michal-kuca/Water-rocket-telemetry/water_rocket_telemetry/Rocket_project_report.docx

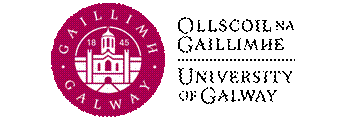
[picture p1: figure]

School of Engineering

Report/Assignment Cover Page

Student/Group Name(s): | Student(s) ID Number:
Michal Kuca Danny Cannon Shifrah Burke Beirne Nicola Latham | 25459142 25377696 25457496 25741946

Class and Year (e.g., 1st Undenominated Engineering): | 1st Undenominated Engineering
Subject Code and Name: (e.g. EI140 Fundamentals of Engineering) | 1EG1
Lecturer Name: | Liam Kilmartin Rajkumar Sarma
Title of Report/Assignment: | NUIG Lander Report
Submission Deadline: | 05/04/2026
Submission Date: | 05/04/2026
Name(s) of Lab Partner(s) (where applicable) | Danny Cannon Shifrah Burke Beirne Nicola Latham Michal Kuca

# 1. Introduction and Aims of the Project

The project aimed to design, build, and safely test a water rocket system that must be capable of launching a capsule and parachute. The system was required to carry a payload consisting of an Arduino system and ensure the capsule could safely descend within specific criteria.

To achieve this, the project was divided into several key stages:

- Design and construct a water pressure-based launcher capable of propelling the rocket to a sufficient height to allow parachute deployment.
- Design and construct a rocket with the ability to hold a capsule built within specified constraints to hold an Arduino system.
- Maximum capsule diameter: 7.5 cm.
- Maximum capsule length: 20 cm.
- Maximum capsule mass: 250g.
- Design, manufacture, and test the parachute system to ensure the capsule returns safely to ground within the required descent speed limits.
- Development and testing of an Arduino program to collect and transmit real-time sensor data, including forces, velocity, altitude and distance during pre-launch, ascent and descent phases.
- Assembly of all components (rocket, capsule, parachute and Arduino system) and testing the launching mechanism while recording flight data.
- Analysis of the collected data to evaluate the rockets performance and dynamics.
- Presentation and reporting of the results and findings.

# 2. Rocket

2.1 The rocket works using a water propulsion system where compressed air forces water out of the bottle to produce thrust. This follows Newton’s Third Law, which states that for every action, there is an equal and opposite reaction. As water is pushed out at high speed, the rocket is pushed upwards.

The thrust produced depends on how fast the water leaves the rocket and how much water is being expelled. For us, we filled our bottle roughly 1/3 of the way. It can be estimated using:

F = mv

Where is F is thrust(force), m is mass (kg/s) and v is velocity of water leaving (m/s).

The velocity of the water depends on the pressure inside the rocket and can be estimated by:

V = √(2P/)

Where P is pressure(Pa) and is density of water(1000 kg/m³).

For the rocket to lift off, the thrust must be greater than its weight:

W=mg

2.2 The rocket is a vital design component of the project because it is used to launch and keep the capsule containing the Arduino system safe. Designs were discussed between the group to decide which would work best for our capsule, parachute and in general on the final testing day.

1. Structure
- Used a plastic bottle as the pressure vessel due to its strength and lightweight properties.
- Filled the bottle partially (about 1/3 full) with water to optimise thrust and flight time.
2. Capsule housing
- Designed a secure nose cone for the top section to hold the capsule and parachute explained in the following sections.
- Protected the capsule inside, including the Arduino which was protected by a sponge, and released safely at a peak height, which for us was 6.16m.
3. Stability
- Chose that our design would include three fins attached at the base of our rocket to ensure it could be free-standing as well as ensuring flight stability.
- Fins ensure the rocket can stand upright before launch and create a stable, straight flight by keeping the centre of pressure below the centre of mass.
4. Propulsion
- Used a water and compressed air system.
- Implemented a football needle valve system using a bicycle pump as required.
- Launch occurs when pressure from the pump through the valve that has been poked through the cork forces the cork-valve system to release, ie. No manual release used.
5. Launch compatibility
- Designed the rocket to fit the provided launch platform and pump system for day of final testing.
- Sealed nozzle tightly to prevent air leaks.
6. Safety considerations
- Used strong materials to withstand pressure, ie. plastic.
- Secure attachments for fins and nose cone.
- Arduino system kept dry inside the capsule using a washer sponge.
- Ensured design creates safe release and controlled descent using a parachute and testing it.
7. Additional
- Streamlined nose cone reduces air resistance.
- Lightweight materials maximise height during launching.
- Balanced mass distribution improves stability.

# 3. Capsule and Parachute System

## 3.1 Capsule

To begin the project the bottles were bought so that the preparation for testing could begin. After watching some previous testing videos, it was decided that a demonstration capsule would be built and the decision on what type of bottle to use for the final capsule would be made upon the results of the test. The bottles that were chosen for the tests were round bottles as when the square bottles were used, they did not seem to sit together as good. For the drop test two small 750ml bottles were used, they were cut up so that they would sit together and there would be a section for the Arduino, for the water and section for the parachute to sit. There was also double layered cardboard used as fins for the stand.

For this test the capsule performed well but it was quickly understood that for the final test a bigger bottle would be needed as the pressure needed to be created in the capsule as the bigger the capsule the more pressure that can be obtained. For the final test 2 large 2 Litre bottles were purchased and similarly they were cut up so the 3 sections could be made.

Three sections needed to be created for the final test, one for the water/ air mixture, one empty section that would hold the parachute and the third and final section that would hold the Arduino. To begin the fins were sketched on cardboard then cut up, double layered and wrapped in duct tape to ensure they were sturdy and wouldn't get weak if water was to get on them. After this the fins were superglued to bottle A, small pieces of duct tape was added to the side of the bottle and the fins to ensure they were stable.

Following this bottle B was cut as only the middle section was needed as this was the section that the top of the capsule was going to be sitting into and where the parachute would be held. The top and bottom of bottle B were then taped together to create a small capsule to hold the Arduino, this worked well as when the mini capsule was placed on top of the big capsule it sat perfectly together.

The mini capsule had to be constructed within the limitations of a 75mm width, 200mm height and a max weight of 250g. In the mini capsule sponges were added to ensure no damage would come to the Arduino if the parachute did not deploy and the mini capsule fell to the ground also there was a hole cut near the top of the bottle so that when the Arduino was placed into the bottle and secured the battery could be accessed.

The plan for the capsule was that when there was enough pressure in the main capsule, the cork would come out and the capsule would fly into the air and then the parachute would deploy, and the mini capsule would then glide downwards whilst the readings being taken on the Arduino.

## 3.2 Parachute

In this project, we had the responsibility of designing a parachute that would slow the capsule's descent by enhancing air resistance. The system is described by the following formula from fluid dynamics to calculate the upwards force created by the parachute:

We calculated the weight of our capsule using this formula:

By making these formulas equal, we could figure out the parachute's radius by rearranging the formula to get the following:

We created a program in MATLAB to show the range of values for the radius based off the mass of the capsule and the velocity of descension desired.

v = input('Velocity: ');

m = input('Mass: ');

fd = m*9.81;

Rho = 1.22;

Drag = linspace(1,1.75,100);

r = sqrt((2*fd) ./ (Rho .* Drag .* pi .* v.^2));

r_max = max(r);

disp(r_max);

plot(Drag,r,"r", 'LineWidth', 2);

xlabel("Drag");

ylabel("Radius");

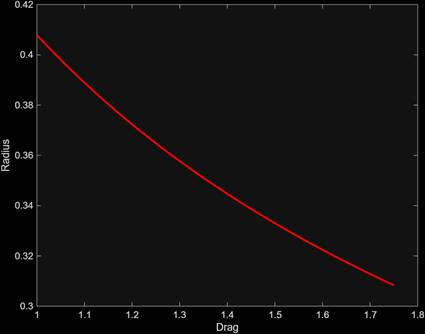
[picture p2: figure]

In the example above, the mass was 130 g, and the falling velocity was two metres. The program states in the least optimal scenario the parachute's radius would be 40.79 cm.

The design process was based on the results of the program.

For the physical construction of the parachute, a black bin bag was cut into a circle with the radius from the program. Then a small incision was made in the centre with a radius of about 2 cm. This step is to control airflow and keep the parachute stable during its descent.

A final design feature of our parachute was its slight domical shape. By removing a 20° sector from the circle, the parachute fills with air to create a dome shape, leading to more air being caught.

With the parachute cut, eight lengths of string 1.5x the length of the radius were attached to create the shroud lines. The strings were then collected at the bottom as a pivot for the capsule.

Finally, a hook was added to the apex of the dome where it could be placed on the side of the rocket.

# 4. Arduino System

## 4.1 Arduino System Overview

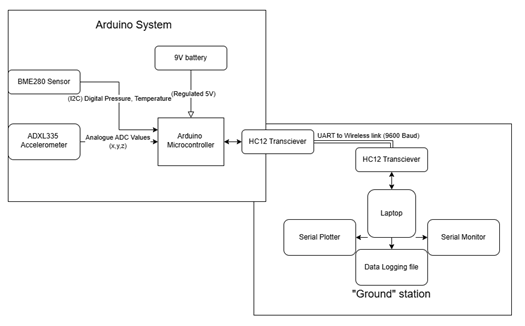
[picture p3: figure]

Figure 1: Arduino System overview

Figure 1 presents an overview of the system used to gather data in this project. The Arduino chip, which functions as the computation centre, is powered by a 9 V battery but receives only regulated 5 V. It receives values from sensors on board the rocket, including the BME280 pressure and temperature sensor and the ADXL accelerometer. This data is then sent via a 433 MHz radio wave to the laptop on the ground, which enables monitoring, plotting, and logging of the data received.

## 4.2 Arduino System components

4.2.1 ADXL335 Accelerometer

The ADXL335 accelerometer transmits analogue signals to the Arduino Nano for accelerations in X, Y and Z directions. The sensor (As simplified by figure 2) functions on the principle of a proof of mass (one in each direction), which moves between fixed plates, changing capacitance.

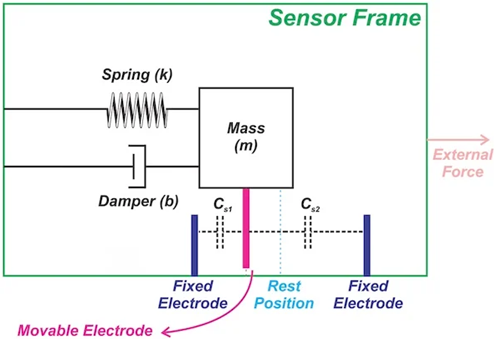
[picture p4: figure]

Figure 2: MEMS accelerometer (DigiKey, n.d.)

Capacitance is defined as:

Figure 3: Capacitance Formula

Where and are constants, and is the area of overlap between the plates, and d is the separation between plates. Therefore, with constant plate area, capacitance is inversely proportional to the separation distance.

As the sensor casing accelerates (due to an external force), the mass m, suspended on elastic bands, lags behind due to inertia (Last Minute Engineers, n.d.). This changes the size of the separation , and the capacitance. This value is converted to a voltage signal within the accelerometer’s internal circuits, and is sent to the Arduino board. The Arduino board then uses an ADC (analogue to digital converter), which converts signals to values between 0-1023.

### 4.2.2 BMP280 Sensor

The BMP280 detects changes to barometric pressure using a piezoresistive pressure sensor – a sensor which varies electrical resistance due to pressure or compression. The internal, ‘silicon diaphragm’ (Bosch Sensortec, 2015), bends based on atmospheric pressure. Similarly, the chip measures temperature using a bandgap sensor (Bosch Sensortec, 2015). Unlike the accelerometer, this sensor includes an ADC, and sends digital, temperature and pressure values to the Arduino board. Altitude is then calculated separately, based on these two readings, using ground pressure as a reference point.

### 4.2.3 HC12 Radio Link

The system utilises a radio communication system, using two HC12 Transceiver modules, connecting the Arduino to the ground station. (Figure 1). The Arduino sends the processed sensor data (as a csv formatted string) to the HC12 module. The baud rate was set to the default setting of 9600 baud, (9600 bits of info transferred per second).

The necessary baud rate can be estimated by calculating the amount of info sent from the Arduino. Given that there were 7 float values sent, as well as the ‘,’ delimiters, and a ‘newline’ operator. There are circa 60 characters per line. As each character in UART is around 10bits (Salisbury, 2017), the total transferred in one sample is

As the controlled sampling rate was 100ms, we can calculate the baud rate by:

Figure 4: Baud rate formula (Sarma, 2026)

= 6000 Baud

This would mean that the amount of data transferred is 62.5% of its maximum rate. As lower baud rates increase reliability, but decrease transmission speed and can risk buffer overflow. Therefore, this rate was deemed sufficient to balance these two factors.

Upon transmission the ‘rocket’ HC-12 module converts the serial data into a 433 MHz radio frequency (Hughes, 2016). The ‘ground’ HC-12 then reads the signal, and the signal is ‘demodulated’ back into the original (Serial) format (Hughes, 2016). This data is then received by the computer/laptop and displayed using Serial Plotter.

## 4.3 Arduino Program

## 4.3.1 Core Structure

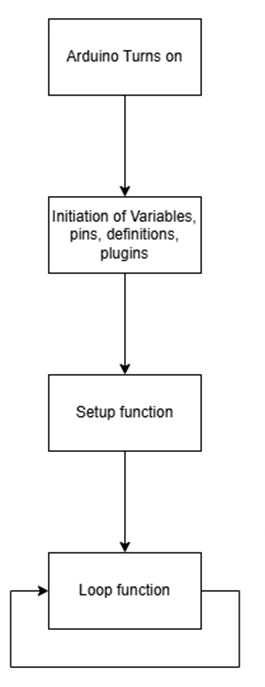
[picture p5: figure]

Figure 5: Arduino core implementation

After powering on, the programme uploaded to the Arduino compiler initialises global variables and defines pins and libraries which are included. Commands which are only to be run one time are executed using the setup function. For the purposes of this program, for example, temperature and ground pressure readings are swept:

for(int i=0;i<10;i++){

float P=climate_sensor.readPressure()/100

float T=climate_sensor.readTemperature()

sumP=sumP+P;

sumT=sumT+T;

delay(50); //the pressure readings will be done in 0.5s

}

ground_pressure= sumP/10; //takes the average

launch_temp= sumT/10;

}

Figure 6: Initial Temperature and Pressure readings

The setup function also defines sensor inputs and initialises Serial, I2C and the HC12 connection.

Loop function contains the active element of the code, which updates indefinitely after startup is finished, its basic components outlined by Figure 14.

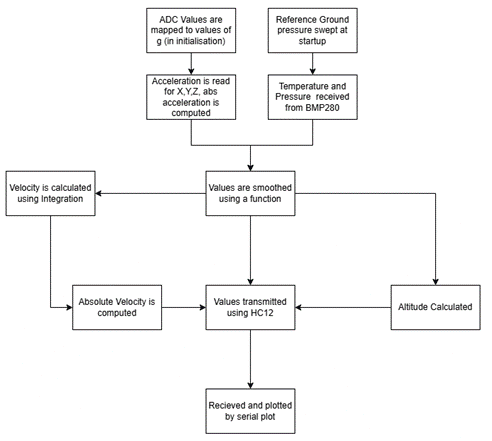
[picture p6: figure]

Figure 7: Drop test Data Flow Arduino

### 4.3.2 Data Processing

Acceleration calculation

Initially, Minimum and Maximum values for 1g are declared, after calibration. After determining the Range as the difference between these values , and ( as the Centrepoint (Sarma, R. 2026).

float readAcceleration(float rawValue, float offset, float scale){

float accel = 0.0;

accel = (rawValue - offset)*(9.81 / scale);

return accel;

}

Figure 8: Read Acceleration function

Then, each accelerometer reading in the main loop was normalised by subtracting the offset and mapped, by multiplying by the scale. (Sarma, R. 2026) This value was then multiplied by 9.81 to give acceleration in m/s^2. (Figure 8).

Furthermore, to reduce acceleration readings caused by ‘accelerometer noise’ (vibration etc.) and other hardware limitations, acceleration readings were nullified when net acceleration was less than 1/10th of 1g, using a threshold shown in figure 8:

if (ab_accel<1){ //if acceleration is less than 1m/s^2, assume stationary to prevent drift

ab_accel=0;

}//note that 9.81 was deducted to account for gravitational acceleration

Figure 9: Acceleration threshold

Data smoothing

To make raw sensor values less varied and easier to interpret, this data was normalised using moving averages. This was important in ensuring that data didn’t fluctuate, which helped with consistent mode detection.

for (int i=filterSize-1;i>0;i--){

//makes 3th value the 4th, makes 4th value 5th

buffer[i]=buffer[i-1];

sum +=buffer[i];

}

buffer[0]=newValue;

sum=sum+newValue;

return sum/filterSize;

}

Figure 10:Moving average function

The ‘for loop’ runs backwards from the last number within the buffer, to the most recent value, shifting values one step backwards every loop iteration. Then the ‘empty’ slot is filled with the current value, to be used in the next iteration.

Therefore, instead of returning raw sensor readings, the average of ‘n’ most recent values is returned, giving a ‘trend’ of the last n values, (n is a variable ‘FilterSize’ within the initiation of the program).

Velocity calculation

To derive velocity, linear acceleration was integrated manually at each iteration of the loop, using the standard kinematics formula:

Figure 11: Velocity formula

This function was invoked for each of the axes. (After testing, X and Z axis were generally omitted, as absolute values were found to be more accurate.)

Velocity calculated in this way was very prone to drift, which made it, increase drastically given acceleration. Therefore, to give accurate readings throughout the launch test, the numeric integration was paused until launch. This was done using a boolean-like condition, which would have to be passed, in order for the velocity calculation to be initiated:

if (mode>0){

threshold=1; //threshold for integrating velocity, only starts once launch is detected

}

Figure 12: Integration Threshold condition

To further reduce drift, damping was utilised, reducing velocity by 1% every loop iteration, to artificially shift it towards 0.

## 4.4 Sampling Rate

The sampling rate in this project is the interval between each consecutive data package read (and sent). This is crucial in determining the precision of the data and balancing reliability of the hardware and data. For the purposes of the project, the sampling rate involves the sensor reading time, processing time of the Arduino chip, transmission of the data vie HC-12 module, as well as delays implemented within the code.

While a higher sampling rate increases the dataset read within the flight, the marginal utility of this data also decreases, when a higher sampling rate does not track meaningful changes within the rocket motion. Higher sampling rates also increase computational load, and risk instability and variation in sampling rate.

For this project a 100ms interval between each reading was implemented, (10Hz). While this is very low, for rocket launch projects (Braun et al., 2016), the hardware limitations, and the nature of the launch made this rate acceptable.

To compensate for processing time, and ensure a more consistent sampling rate, the processing time was recorded by finding the time between the previous full loop and then deducting the previous processing time from the delay timer:

Proc_time= (Sampling _interval-(millis()-Tnew));

if (Proc_time<Sampling_interval){

delay(Sampling_interval-Proc_time);// delay for main(loop)

}

else{

delay(0); //in case processing time is greater than sampling interval, we attempt to minimize it by removing delay completely

Tnew= millis();

}

Figure 13: Accounting for processing time

## 4.5 Launch Implementation

## 4.5.1 Main Loop

The system records time at the start of each loop to calculate sampling interval, time since start/ and time since launch (depending on mode). Following this, sensor readings are processed, as shown in section 2.1. Variables in (Figure 20), such as maximum altitude are updated continuously, stored and selected variables are transmitted in-flight via HC-12 module. The loop then checks whether a mode has been reached, and if so, ‘sweeps’ the relevant data, as well as timestamps for when this occurred: Maximum Acceleration and ascent Velocity for mode 1, Maximum acceleration and descent velocity for mode 2, and maximum force. These variables are then transmitted in the summary (figure 18), at landing, independent of the in-flight data printed in the loop.

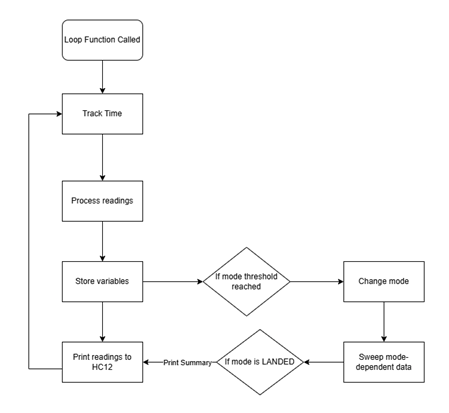
[picture p7: figure]

Figure 14:'Main' loop Launch test implementation

### 4.5.2 Mode Function

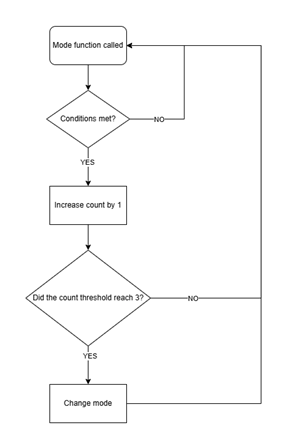
[picture p8: figure]

Figure 15: Mode algorithm

As shown by figure 15, the state of the rocket was detected using if statements, and parametric conditions based on the Arduino readings. If these thresholds were reached, the ‘mode’ would increase to, ‘PRELAUNCH’, ‘ASCENT’, ‘DESCENT’ and ‘LANDED’ in the given order. This function was called every iteration of the loop, and the conditions were updated accordingly.

To make the algorithm less volatile, 3 separate readings were needed to prompt a change of state, with the required conditions continuously adjusted based on experimentation.

Following multiple tests, the parameter which was most consistent with modelling the motion of the Arduino capsule was altitude based on the BMP280 pressure readings (Viz Results section). Therefore, the final code implementation was primarily based on altitude, with absolute acceleration as a safety fallback.

As an example, descent would be signified by a significant decrease in the altitude,

else if((mode==1)&&(alt_smooth < Altitude_max-1)&&(millis()>2000))

{

DES_CNT++;

}

Therefore, the parameter for detecting descent was 1 meter drop from the max altitude, with maximum altitude being a variable updated every loop iteration. To meet the condition, the mode would also have to be set to Ascent, to prevent non-linear mode progression.

Similarly, ascent was detected, per acceleration of the capsule, as well as an altitude threshold:

if((mode==0)&&(alt_smooth>1.5)&&(ab_accel>6)

{

ASC_CNT++;

//descending //ascending: z acceleration,

}

This means, both conditions had to be met for the state change to be successful, making acceleration launches less likely to occur prematurely.

While relying on altitude readings increased robustness of the algorithm, detecting ascent and descent, only after the rocket had already moved would decrease the time window in which mode-dependent readings could be gathered (e.g. Ascent and Descent Velocity). This can be seen in figure 21, as ascent mode is detected late.

### 4.5.3 Robustness and Testing Adjustments

The Arduino was tested extensively, using test launch conditions, to adjust parameters and logic of the mode-selecting algorithm. Early versions used ideal conditions such as a 0-velocity requirement to prompt the change of state from ascent to descent (at the peak of the flight path), and relied on accelerations in X, Y and Z axis. (If acceleration with vertical axis was negative, descent was activated.) However, the algorithm could only be functional, once applicable to real conditions and readings, rather than ideal scenarios.

To test these systems, launches were carried out, displaying ‘rocket state’ in real time to identify errors. In some experiments, the capsule would also be moved erratically before launch, to test whether mode would activate too early. This allowed the team to identify the following issues/ problem scenarios:

A. False triggers

If the board was manipulated before launch, causing it to accelerate and/or shift orientation, the mode for launch and descent could switch too early. Likewise, the landing state would be activated too early in the capsule’s descent, which would cause modes to ‘jump from one another’ and fail to print the summary.

B. Incomplete landing

This constituted a launch, in which the rocket was caught on a balcony ledge, preventing conditions for landing to be met, and therefore there was no summary printed.

C. Signal loss

In testing, the team lost signal from the HC12 transceiver, due to leaving the range of reliable radio communication facilitated by the hardware component.

D. High processing time and freezes in the plot.

(This was likely caused by a hardware issue, as the microprocessor did not receive stable voltage from the battery, and led to an Arduino board replacement).

A.

To counter random mode progression, a condition was added which required the previous mode to be active to facilitate a switch. Additionally, a counter was required to be passed after the landing to delay the printing of the summary and gather additional info after ‘LANDED’ was detected.

B.

Secondly, a ‘Safety timer’ was implemented, as mode ‘LANDED’ would activate automatically, 60 seconds after the Arduino start. This caused the flight summary to print regardless of mode and allow for debugging.

C.

To counter the Arduino chip flying in and out of range of the transceiver, the summary was printed continuously using the delay function, even after landing, instead of pausing the code indefinitely.

D.

To reduce load on the processor, ‘Strings’ were broken down, and variables printed directly using ‘HC12.print’.

The corresponding adjustments are shown in figure 16:

Scenario | Original Code | Adjustment
A | else if(mode==LANDED){ Flight_duration=(millis()/1000)-T_prelaunch; //records flight duration //prints summary } | else if(mode==LANDED){ Flight_duration=(millis()/1000)-T_prelaunch; landedwait++; if (landedwait>40){ //prints summary }
B | else if((ab_accel < 4)||(alt_smooth < 2) { LAN_CNT++; } | else if ((mode==2)&&((ab_accel < 4)||(alt_smooth < 2)||(millis()>600000))) { LAN_CNT++; }
C | while(1){ } | delay(10000);
D | String Velocities = ""; Velocities = String(velocity_x) + "," + String(velocity_y) + ","… String Accelerations = ""; Accelerations = String(X_smooth) + "," … HC12.println(Accelerations + "," + Velocities + "," + Temp_alt); | HC12.print(mode); HC12.print(","); HC12.print(Y_smooth); HC12.print(","); HC12.print(ab_accel); HC12.print(","); HC12.println((millis()/1000)-T_prelaunch); …

Figure 16: Code adjustments

# 5. Testing

## 5.1 Drone drop test

During our research we tested many different ways to allow the parachute to deploy after being launched from the rocket. Our first design had the parachute beneath the capsule. The concept was that the capsule's upward momentum from the rocket would propel it along with the parachute. Unfortunately, the parachute would continue to get stuck on the capsule. Our next attempt, we decided to pin the apex of the parachute to the capsule container. This proved very effective. Paired with the placement of the parachute on the capsule, the parachute consistently deployed.

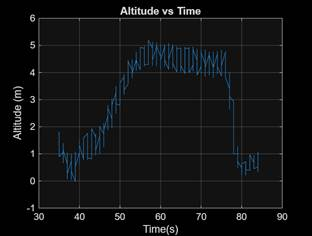
[picture p9: figure]

Figure 17: Drop test Altitude profile

Figure 17 displays altitude data throughout the drop test. As the capsule was lifted, its altitude increased to a maximum of 5.13 metres, and eventually was dropped, rapidly descending.

In contrast, data for acceleration and velocity, was very inconsistent in this test due to poor calibration, and lack of thresholds. The maximum acceleration for the drop test (after smoothing) read 16.31m/s^2, which is considered unrealistically large for this form of drop test, and it could be observed that this acceleration was not true to the experiment. For this reason, velocity readings were also unreliable due to drift, increased exponentially, and did not produce reliable data.

## 5.3 Rocket Launch Test

### 5.3.1 Observations

Our initial tests of the rocket were a tremendous success. The rocket would launch consistently and stay intact. All our tests went well. The only time we had a major issue with launching the rocket was on launch day. Our final practice test failed. The cork was not as tight as it needed to be, allowing air to escape and not allowing the chamber to become pressurised. The capsule holder also fell off, contributing to the failure. However, these were easy fixes, as we just re-taped the holder and replaced the worn cork with a brand-new one. After these repairs, the rocket launched without issues.

### 5.3.2 Results

Summary

The rocket launch was executed at a temperature of 26.04 °C

the maximum acceleration during its ascent was 11.05 m/s², at time T+ 0.49 s

the maximum ascent velocity reached was 5 m/s

the maximum altitude reached was 6.16 m, at time T+ 1.70 s

the maximum acceleration during its descent was 5.53 m/s², at time T+ 2.3 s

The capsule landed safely at a time of 2.7s with a maximum descent velocity of 4.28 m/s (2.6 s)

The maximum thrust was 2.76 N.

Figure 18: In flight summary

On the rocket’s roughly 4 second flight path, all 4 modes were successfully activated, data was gathered and summary printed. The in-flight summary in figure 18 successfully reported the key values reported during the test. The validity of the values will be assessed in detail in the following section.

The ‘maximum thrust’ represented the net upward force, calculated through newtons second law:

Figure 19: Newton’s second law

mode | Y acceleration (m/s^2) | Absolute Acceleration (m/s^2) | Y velocity (m/s) | Absolute velocity (m/s) | Altitude (m) | Temperature C ° | Force N | Time since launch (s)
0 | -0.63 | 0 | 0 | 0 | -0.82 | 26.34 | 0 | 0.222
0 | 2.89 | 3.74 | 0 | 0 | -0.86 | 26.35 | 0.94 | 0.333
0 | 3.22 | 4.71 | 0 | 0 | -0.39 | 26.35 | 1.18 | 0.444
0 | 1.88 | 5.22 | 0 | 0 | 0.38 | 26.35 | 1.31 | 0.556
0 | 0.29 | 6.07 | 0 | 0 | 0.99 | 26.36 | 1.52 | 0.667
0 | -0.07 | 4.73 | 0 | 0 | 1.73 | 26.36 | 1.18 | 0.778
0 | -1.25 | 5.17 | 0 | 0 | 2.52 | 26.36 | 1.29 | 0.889
1 | -5.34 | 8.33 | 0 | 0 | 3.38 | 26.36 | 2.08 | 1
1 | -6.25 | 9.53 | -0.64 | 0.98 | 4.02 | 26.36 | 2.38 | 1.111
1 | -6.2 | 10.06 | -1.27 | 2 | 4.39 | 26.36 | 2.51 | 1.222
1 | -6.28 | 9.79 | -1.9 | 2.96 | 4.96 | 26.36 | 2.45 | 1.333
1 | -7.17 | 11.05 | -2.61 | 4.05 | 5.46 | 26.36 | 2.76 | 1.444
1 | -7.45 | 8.53 | -4.66 | 6.66 | 6.12 | 26.36 | 2.13 | 1.778
1 | -3.1 | 4.85 | -4.89 | 6.98 | 6.01 | 26.36 | 1.21 | 1.889
1 | -2.02 | 3.7 | -5 | 7.16 | 5.77 | 26.36 | 0.92 | 2
1 | -0.07 | 3.96 | -4.91 | 7.22 | 5.31 | 26.36 | 0.99 | 2.1
1 | 0.91 | 4.27 | -4.72 | 7.22 | 4.48 | 26.36 | 1.07 | 2.2
1 | 1.03 | 4.22 | -4.51 | 7.22 | 3.7 | 26.36 | 1.05 | 2.3
2 | 1.39 | 4.53 | -4.28 | 7.25 | 3.36 | 26.37 | 1.13 | 2.4
2 | 0.26 | 4.06 | -4.17 | 7.37 | 2.98 | 26.37 | 1.01 | 2.5
2 | -0.07 | 3.45 | -4.09 | 7.46 | 2.91 | 26.37 | 0.86 | 2.6
2 | -0.07 | 0 | -4.01 | 7.31 | 2.92 | 26.37 | 0 | 2.7
3 | -0.41 | 0 | -3.93 | 7.17 | 3.31 | 26.37 | 0 | 2.8
3 | -0.02 | 0 | -3.85 | 7.02 | 3.61 | 26.37 | 0 | 2.9
3 | 0.99 | 3.2 | -3.67 | 6.93 | 3.39 | 26.37 | 0.8 | 3
3 | -0.87 | 0 | -3.6 | 6.79 | 3.24 | 26.37 | 0 | 3.111
3 | 1.03 | 3.34 | -3.42 | 6.68 | 2.84 | 26.37 | 0.84 | 3.222
3 | 0.7 | 3.1 | -3.28 | 6.61 | 2.44 | 26.37 | 0.78 | 3.333
3 | 0.05 | 0 | -3.21 | 6.48 | 2.08 | 26.37 | 0 | 3.444
3 | 1.88 | 4.31 | -2.96 | 6.41 | 1.71 | 26.37 | 1.08 | 3.556
3 | 0.84 | 3.51 | -2.81 | 6.41 | 1.46 | 26.38 | 0.88 | 3.667
3 | 1.15 | 3.84 | -2.63 | 6.45 | 1.25 | 26.38 | 0.96 | 3.778
3 | 0.02 | 3.43 | -2.58 | 6.57 | 1.02 | 26.38 | 0.86 | 3.889
3 | -0.43 | 3.16 | -2.57 | 6.7 | 0.93 | 26.38 | 0.79 | 4
3 | 0.19 | 3.35 | -2.5 | 6.85 | 0.78 | 26.39 | 0.84 | 4.1
3 | 0.46 | 3.54 | -2.4 | 7.02 | 0.71 | 26.39 | 0.89 | 4.2
3 | 0.46 | 3.91 | -2.31 | 7.25 | 0.42 | 26.39 | 0.98 | 4.3
3 | 0.34 | 3.91 | -2.23 | 7.47 | 0.06 | 26.39 | 0.98 | 4.4

Figure 20: Table of In-flight statistics

Figure 20 displays all data collected during the rocket launch test.

### 5.3.3 Data analysis

Figure 21 shows the altitude profile during the launch test, with its maximum altitude (6.16 metres) being the peak.

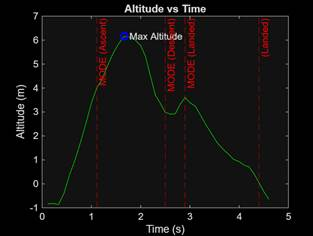
[picture p10: figure]

Figure 21: Flight Altitude Profile

Unexpectedly, while modes reliably switched, the ‘landed’ rocket state was activated early, as its condition was either a low altitude, or low acceleration. The deployment of the parachute caused this switch to occur, as the rocket suddenly decelerated. This limited the time given for the program to search for a maximum acceleration and velocity during its descent. The rocket’s ascent started before the ascent mode was activated, and it landed about a second after ‘LANDED’ was detected by the Arduino, as shown on the graph.

However, a maximum acceleration of 11.05m/s^2 on its ascent and 5.53 m/s^2 on its descent, is plausible for the purposes of the experiment.

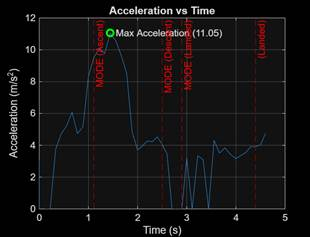
[picture p11: figure]

Figure 22: Flight Acceleration Profile

The ‘dip’ in figure 22, as acceleration goes to its null threshold, translates to the deployment of the parachute, (and the premature mode switch). However, the net acceleration can also be said to be reliable, successfully modelling:

1. Rapid acceleration in the launch stage of its flight
2. deceleration at its peak height
3. Acceleration on its descent prior to parachute deployment
4. Deceleration due to parachute deployment
5. Slight acceleration after parachute deployment

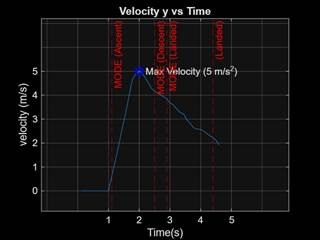
[picture p12: figure]

Figure 23: Flight Velocity Profile

The velocity increases expectedly during ascent and decreases during descent, with its maximum value 5m/s^2 consistent with the summary data, and observations. However velocity stays positive during descent, which is not physically correct, as the curve should become negative to indicate motion in the opposite direction of the axis.

This curve can be numerically integrated to receive total distance travelled by the rocket.

Integrating using trapezoidal integration in MATLAB outputs: 10.9m. Because of late mode detection, as velocity in only calculated once ascent is detected (1.5m off the ground), we can add this value to get an estimation for the total distance travelled.(12.4m).This value matches well with the altitude reading, as maximum altitude was 6.16m, and therefore the rocket travelled 12.32m vertically (up and down). However, it is unlikely that this method will produce a consistently accurate estimation of the flight path distance.

### 5.3.4 Accuracy and limitations

Accuracy of the data gathered was limited by the tools and methods in conducting the experiment as well as data processing. Along with limitations of the accelerometer readings and calibration itself, the vertical axis was normalised by subtracting gravitational acceleration (9.81m/s^2) . However, as orientation of the rocket changes during the flight (as the sensor isn’t stabilised), acceleration in the y axis is likely greater than the displayed data, as gravity is being overcompensated.

Other limitations include, the method of velocity integration, as this value was highly sensitive to measurement errors, which would accumulate during integration. The method of damping this value, by reducing it every loop would also produce results, more distant from real sensor readings. Thirdly, the sampling rate also inherently reduces accuracy, as data is only seen at certain points, which can cause data to be ‘neglected’ or skewed.

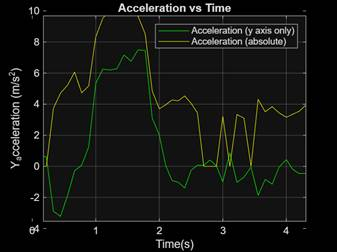
[picture p13: figure]

Figure 24: Acceleration and Acceleration Absolute

Figure 23 compares the use of absolute acceleration and acceleration in the y -axis. While absolute acceleration would show a clearer picture of the net motion of the rocket, ideally, when the rocket was aligned, negative values would show the vertical direction of the motion. For example, at a time of 2s, the y acceleration shows the initial downwards acceleration before the parachute deployment, while the net acceleration stays high, also representing side -to-side movement of the capsule. Together this data enables the determination of descent and ascent retrospectively. However, due to rotation of the Arduino capsule, focusing on a singular axis is less reliable overall, for determining maximum acceleration values.

6. Individual contributions and Project Management

Team member 1: Danny Cannon (25459142): Aided with the overall design of the rocket and parachute. Construction of the parachute. Performed drop tests for the parachute. Wrote up the parachute, drone drop test, and rocket test launch sections of this report. Created the video. Launched the rocket.

Team member 2: Shifrah Burke Beirne (25377696): Helped with the design and construction of the capsule and parachute with the team. Focused on details and design concerning the rocket and launching mechanism, including testing different designs during parachute testing and before final testing with the team. I completed section 1, Introduction and Aims, and section 2, Rocket, of the final report.

Team member 3: Nicola Latham (25457496): Contributed to the overall design of the rocket, constructed the demonstration and final capsule. Contributed alongside the team with the design and testing of different aspects that would affect the rocket and the final capsule. Completed the capsule and sustainability section of the report.

Team member 4: Michal Kuca (25741945):

Was responsible for the Arduino system and programming, as well as gathering data from the experiments. Wrote section 4 of the report. Processed the test data using MATLAB and contributed largely to section 5 of the report, assessing the data and the methods used to produce it.

# 7. Sustainability Considerations

We cut a hole into the side of the capsule to allow us to connect and disconnect the wires from the battery. This modification saved us from having to physically open and close the capsule; therefore, we saved tape.

To help reduce the waste of plastic when creating the capsule the decision was made to reuse parts of the bottles that were previously cut up, this meant that another bottle did not need to be cut up and wasted. When designing the fins recycled cardboard was used and the design of the fins was drawn out on the cardboard to reduce waste.

# 8. Individual Reflections

Team member 1: Danny Cannon (25459142): While working on this project, I developed an understanding of what is required to complete a project like this. I feel as though this project allowed me to work on my social skills and develop my communication with others. This project taught me the capabilities of the Arduino, and I believe I have only begun to explore its potential. I believe that this project has taught me more about the way a project in a workplace would be commenced, based on designing, building, testing, and fixing the rocket. The process felt genuine and gave me a great sense of pride. I am grateful for my teammates, as they have put in so much effort into this project.

Team member 2: Shifrah Burke Beirne (25377696): Through completing this project, I developed a deeper understanding of how physics applies to real-world engineering problems. I also learned that teamwork is extremely important in doing projects like this because of the amount of work that has to be put in. I improved some practical skills in designing, building and testing the rocket. My problem-solving skills have become better during the project, particularly when adjusting to improve the performance of the rocket. Overall, the project showed me the importance of planning, testing and refining a design to achieve the best possible results.

Team member 3: Nicola Latham (25457496): From this final project I have learned how important team work is, if we all did not work together as a team I don't believe that the project would have been a success. This project also included a lot of time outside the lab where our team met up and worked together developing our skills as engineers working through problems and testing different aspects to see what would work best.My personal skills have developed throughout this module but especially during this project as we did face some problems right before the final testing but we had to act quickly to solve them. I have developed better team working, problem solving and planning skills throughout this project and this contributed to the success of the project.

Team member 4: Michal Kuca (25741945):

As the last project, the ‘Galway Lander’ required me to invest a lot of time and effort, taking responsibility for coding the Arduino Nano and data processing. I learned to approach a technical engineering problem and that debugging code can often be a tedious but rewarding process. I also learned how teamwork is important to put all the parts of the rocket together and test it as a unit. Personally, it was nice to analyse my process retrospectively in this report, but felt a lack of time to allow me to write to an excellent standard, but am ultimately happy with the work we’ve produced.

References:

Last Minute Engineers. (n.d.). ADXL335 accelerometer Arduino tutorial.
https://lastminuteengineers.com/adxl335-accelerometer-arduino-tutorial/

DigiKey. (n.d.). Accelerometer types, applications, and selection tips.
https://forum.digikey.com/t/accelerometer-types-applications-and-selection-tips/44520

Bosch Sensortec. (2015). BMP280 Digital Pressure Sensor Datasheet. Bosch Sensortec GmbH.
https://www.bosch-sensortec.com/products/environmental-sensors/pressure-sensors/bmp280/

Patel, A. K., & Jadhav, R. (2026). An Arduino-enabled barometric validation of the hydrostatic equation using BMP280 sensor. Physics Education.

https://iopscience.iop.org/article/10.1088/1361-6552/ae1dd6/meta

Salisbury, B. (2017). Portable wireless measurement and control system (Master’s thesis, University of Rhode Island).
https://digitalcommons.uri.edu/cgi/viewcontent.cgi?article=2039&context=theses

Sarma, R. (2026). Engineering design (EL150): Lecture 4 [PowerPoint slides]. University of Galway.

Hughes, M. (2016, November 2). Understanding and implementing the HC-12 wireless transceiver module. All About Circuits.

Is

Braun, B., Markgraf, M., & Montenbruck, O. (2016). Performance analysis of IMU-augmented GNSS tracking systems for space launch vehicles. CEAS Space Journal. https://doi.org/10.1007/s12567-016-0113-9

Appendix 1: Code

#include <Adafruit_BMP280.h>

#include <Wire.h>

#include <SoftwareSerial.h>

#define xPin (A1) //pins in arduino that go into x y and z values in accelerometer

#define yPin (A2)

#define zPin (A3)

#define USE_BMP280

Adafruit_BMP280 climate_sensor;

//HC-12 Wireless Transceiver

SoftwareSerial HC12(7,6); //7 is TX and 6 is RX

//thresholds for acceleration (m/s^2)

#define VELOCITY_INTEGRATION_THRESHOLD 3 //threshold for velocity calculation

#define ABSOLUTE_ACCELERATION_THRESHOLD 2 //assumes stationary if lower

//threshold for state machine (m)

#define LAUNCH_ALTITUDE_TRIGGER 1.5 //trigger for mode switch to launch

#define DESCEND_ALTITUDE_DECREASE 1 //trigger for mode switch to descending

#define REST_ACCELERATION_NOISE 4 //tolerated acceleration noise, in detecting landing

#define LANDED_ALTITUDE 1//maximum landed altitude

//velocity starts at 0

float velocity_x = 0;

float velocity_y = 0;

float velocity_z = 0;

float velocity_abs = 0;

float Altitude_max;

float Acceleration_ascent_max=0;

float Acceleration_descent_max=0;

float Flight_duration;

float maxVelocity_zAscent = 0;

float maxVelocity_zDescent = 0;

float ground_pressure;

float launch_temp;

float Temp_min=100;

float rocket_mass=0.25;//mass in kg

float force=0;

float T_prelaunch=0;

float T_accel_ascent;

float T_Altitude_max;

float T_accel_descent;

//smoothing out data function

const int filterSize = 6;

float xAccelBuffer[filterSize]={0};

float yAccelBuffer[filterSize]={0};

float zAccelBuffer[filterSize]={0};

float pressureBuffer[filterSize]={0};

float temperatureBuffer[filterSize]={0};

float altitudeBuffer[filterSize]={0};

//functions

float calculatevelocity(float v,float a,float dt);

float movingAverage(float* buffer, float newValue);

float readAcceleration(float rawValue, float offset, float scale);

//add rocket state

int landedwait=0;

//Measured values after the Accel Calibration111

const int X1gMax = 396; //g acting on x

const int X1gMin = 258;

const int Y1gMax = 400; //g acting on y

const int Y1gMin = 264;

const int Z1gMax = 433; //g acting on z

const int Z1gMin = 296;

// offset and scale calculations

float Z_offset = (Z1gMax + Z1gMin)/2;

float Z_scale = (Z1gMax - Z1gMin)/2;

float Y_offset = (Y1gMax + Y1gMin)/2;

float Y_scale = (Y1gMax - Y1gMin)/2;

float X_offset = (X1gMax + X1gMin)/2;

float X_scale = (X1gMax - X1gMin)/2;

float dt=0;

float sumP=0; //for finding ground pressure and temperature

float sumT=0;

unsigned long Tlast;

unsigned long Tnew;

unsigned long Sampling_interval=100; //sampling time in ms

unsigned long nextSampleTime;

int DES_CNT=0;

int ASC_CNT=0;

int LAN_CNT=0;

const int PRELAUNCH =0;

const int ASCENT =1;

const int DESCENT =2;

const int LANDED =3;

int mode = PRELAUNCH; //current mode

int threshold=0;

void setup() {

Tlast=millis(); //should be the time right before the main loop starts running

// put your setup code here, to run once:

HC12.begin(9600); //begins printing to transciever

HC12.println("mode,Y acceleration,Absolute acceleration,Y velocity,Absolute velocity,Altitude,Temperature,Force,Time since launch");

Serial.begin(9600); //begins printing to code

//check if BME is working

Wire.begin();

if (!climate_sensor.begin(0x76)) { //if climate sensor fails

Serial.println("Climate Sensor sensor not found!");

while (1);

}

Serial.println("BME280 working");

//find ground pressure at start

for(int i=0;i<10;i++){

float P=climate_sensor.readPressure()/100;

float T=climate_sensor.readTemperature();

sumP=sumP+P;

sumT=sumT+T;

delay(50); //the pressure readings will be done in 0.5s

}

ground_pressure= sumP/10; //takes the average

launch_temp= sumT/10;

nextSampleTime = millis(); //starts timer

}

void loop() {

// put your main code here, to run repeatedly:

// reads current values

float rawValueY= analogRead(yPin);

float rawValueZ= analogRead(zPin);

float rawValueX= analogRead(xPin);

//reads values from function

float Z_accel = readAcceleration( rawValueZ, Z_offset, Z_scale);

float X_accel = readAcceleration( rawValueX, X_offset, X_scale);

float Y_accel = readAcceleration( rawValueY, Y_offset, Y_scale)-9.81;

float altitude=climate_sensor.readAltitude(ground_pressure); //measures m above reference (ground) point

float pressure = climate_sensor.readPressure()/100;//converts to kilopascals

float temperature = climate_sensor.readTemperature();

float temp_smooth=movingAverage(temperatureBuffer,temperature);

//normalizes accel values

float X_smooth=movingAverage(xAccelBuffer, X_accel);

float Y_smooth=movingAverage(yAccelBuffer, Y_accel);

float Z_smooth=movingAverage(zAccelBuffer, Z_accel);

float alt_smooth=movingAverage(altitudeBuffer, altitude);

float pressure_smooth=movingAverage(pressureBuffer,pressure);

//prints normalised values for accel

//finds absolute acceleration using pythagoras

float ab_accel=(sqrt(X_smooth*X_smooth+Y_smooth*Y_smooth+Z_smooth*Z_smooth));

if (ab_accel<ABSOLUTE_ACCELERATION_THRESHOLD){ //if acceleration is less than threshold, assume stationary to prevent drift

ab_accel=0;

}

if (mode>0){ //only start integrating after launch

threshold=1; //threshold for integrating velocity, only starts once 6m/s is reached

}

//timer for integration: in function to be synced with acceleration

Tnew=millis();

dt=(Tnew-Tlast)/1000.0;

//changed into: (seconds)

if (threshold==1){

velocity_x=calculatevelocity(velocity_x,X_smooth,dt, ab_accel); //calculates (x) velocity

velocity_y=calculatevelocity(velocity_y,Y_smooth,dt, ab_accel); //calculates (y) velocity

velocity_z=calculatevelocity(velocity_z,Z_smooth,dt, ab_accel); //calculates (z) velocity

velocity_abs=sqrt(velocity_x*velocity_x+velocity_y*velocity_y+velocity_z*velocity_z); //calculates (absolute) velocity

}

//read and prints pressure values -

force = rocket_mass*ab_accel;

//find altitude from this

// altitude_calc= also use formula and compare?

//climate sensor

//finds current mode

mode = modefunc(mode,ab_accel,alt_smooth);

HC12.print(mode);

HC12.print(",");

HC12.print(Y_smooth);

HC12.print(",");

HC12.print(ab_accel);

HC12.print(",");

HC12.print(velocity_y);

HC12.print(",");

HC12.print(velocity_abs);

HC12.print(",");

HC12.print(alt_smooth);

HC12.print(",");

HC12.print(temp_smooth);

HC12.print(",");

HC12.print(force);

HC12.print(",");

HC12.println((millis()/1000)-T_prelaunch);

if(alt_smooth>Altitude_max){

Altitude_max=alt_smooth;

T_Altitude_max=millis()/1000.0;

}

if(temp_smooth<Temp_min){

Temp_min=temp_smooth;

}

if (mode==PRELAUNCH){

//timer before launch

T_prelaunch=(millis()/1000);

}

else if(mode==ASCENT){ //capture max ascent acceleration and velocity, print velocity ascent etc

if(ab_accel>Acceleration_ascent_max){

Acceleration_ascent_max=ab_accel;

T_accel_ascent=millis()/1000.0;

}

if(velocity_abs>maxVelocity_zAscent){

maxVelocity_zAscent=velocity_abs;

}

}

else if(mode==DESCENT){ //capture descent acceleration and decceleration (due to parashute), print velocity descent

//calculate change in accel to see when parashute is deployed?

if(ab_accel>Acceleration_descent_max){

Acceleration_descent_max=ab_accel;

T_accel_descent = millis()/1000;

}

if(velocity_abs>maxVelocity_zDescent){

maxVelocity_zDescent=velocity_abs;

}

}

else if(mode==LANDED){

Flight_duration=(millis()/1000)-T_prelaunch;

landedwait++;

if (landedwait>40){

//print stats for the flight (the max velocity etc...), time in air, state variables

HC12.print("the rocket launch was excecuted at a temperature of: ");

HC12.println(launch_temp);

HC12.print("the maximum acceleration during its accent was: ");

HC12.print(Acceleration_ascent_max);

HC12.print("m/s^2 , at time: T+ ");

HC12.println(T_accel_ascent);

HC12.print("the maximum ascent velocity reached was: ");

HC12.print(maxVelocity_zAscent);

HC12.println(" m/s ");

HC12.print("the maximum altitude rea0ched was: ");

HC12.print(Altitude_max);

HC12.print(" m , at time: T+ ");

HC12.println(T_Altitude_max);

HC12.print("At a chilly: ");

HC12.print(Temp_min);

HC12.println(" C");

HC12.print("the maximum acceleration during its descent was: ");

HC12.print(Acceleration_descent_max);

HC12.print("m/s^2 , at time: T+ ");

HC12.println(T_accel_descent);

HC12.print("the maximum altitude reached was: ");

HC12.print(Altitude_max);

HC12.print(" , at time: T+ ");

HC12.println(T_Altitude_max);

HC12.print("The rocket landed safely at a time of: T+ ");

HC12.print(Flight_duration);

HC12.print(" s");

HC12.print("With a maximum descent velocity of: ");

HC12.print(maxVelocity_zDescent);

HC12.println(" m/s ");

HC12.print("The maximum thrust was: ");

HC12.print(Acceleration_ascent_max*rocket_mass);

HC12.println(" N");

delay(10000);

}

}

Tlast=Tnew;

nextSampleTime = nextSampleTime + Sampling_interval; //sets the next sampling timestamp

long remainingTime = nextSampleTime - millis(); ///difference between sampling ttime and current time

if (remainingTime > 0) {

delay(remainingTime); //actively delays by the interval-processing time

} else {

//if processing delay is enough, don't delay at all

nextSampleTime = millis(); // resync

}

}

//functions

//function for converting current values to acceleration

float readAcceleration(float rawValue, float offset, float scale){

float accel = 0.0;

accel = (rawValue - offset)*(9.81 / scale);

return accel;

}

//returns moving average num

float movingAverage(float* buffer, float newValue){

float sum=0;

//store previous 5 values

for (int i=filterSize-1;i>0;i--){

//shifts values by 1

buffer[i]=buffer[i-1];

}

buffer[0]= newValue;

//adds in new value

for (int i=0;i<filterSize;i++){

sum=sum + buffer[i];

}

return sum/filterSize;

}

//calculates velocity

float calculatevelocity(float v,float a,float dt, float abs){

if(abs<VELOCITY_INTEGRATION_THRESHOLD){ //does nothing if acceleration threshold isnt reached

return v*0.98;

}

else{

return (v+a*dt)*0.98;

}

}

int modefunc(int mode, float ab_accel,float alt_smooth){

int modeNEW = mode; //keep the same mode if conditions are not met

if((mode==0)&&(alt_smooth>LAUNCH_ALTITUDE_TRIGGER))

{

ASC_CNT++;

//descending //ascending: z acceleration,

}

else if((mode==1)&&(alt_smooth < Altitude_max-DESCEND_ALTITUDE_DECREASE)&&(millis()>2000))

{

DES_CNT++;

}

else if ((mode==2)&&((ab_accel < REST_ACCELERATION_NOISE)||(alt_smooth < LANDED_ALTITUDE)||(millis()>40000)))

{

LAN_CNT++;

}

else{}

if(LAN_CNT>2) //change to whichever axis is alighned with g

{

modeNEW = LANDED; //ascending: z acceleration,

}

else if(DES_CNT>2)

{

modeNEW = DESCENT; //descending

}

else if(ASC_CNT>2)

{

modeNEW = ASCENT; //descending

}

else{}

mode=modeNEW;

return mode;

}
