michal-kuca/Water-rocket-telemetry/water_rocket_telemetry/matlab/Testresults_New2.xls

Sheet: Table1
mode | Y_smooth | ab_accel | velocity_y | velocity_abs | alt_smooth | temp | force | Time | Column1
0 | 0 | 0 | 0 | 0 | 0 | 0 | 0 | 0
0 | 0.05 | 0 | 0 | 0 | -0.16 | 21.8 | 0 | 0
0 | 0.05 | 0 | 0 | 0 | -0.19 | 26.16 | 0 | 0
0 | 0 | 0 | 0 | 0 | -0.17 | 26.17 | 0 | 0
0 | -0.02 | 0 | 0 | 0 | -0.18 | 26.17 | 0 | 0
0 | 0.1 | 0 | 0 | 0 | -0.2 | 26.18 | 0 | 0
0 | 0.12 | 0 | 0 | 0 | -0.23 | 26.18 | 0 | 0
0 | 0.1 | 0 | 0 | 0 | -0.25 | 26.19 | 0 | 0
0 | 0.12 | 0 | 0 | 0 | -0.3 | 26.2 | 0 | 0
0 | 0.14 | 0 | 0 | 0 | -0.35 | 26.2 | 0 | 0
0 | 0.14 | 0 | 0 | 0 | -0.41 | 26.2 | 0 | 0
0 | 0.14 | 0 | 0 | 0 | -0.42 | 26.21 | 0 | 0
0 | 0.14 | 0 | 0 | 0 | -0.4 | 26.21 | 0 | 0
0 | 0.14 | 0 | 0 | 0 | -0.4 | 26.21 | 0 | 0
0 | 0.14 | 0 | 0 | 0 | -0.38 | 26.22 | 0 | 0
0 | 0.14 | 0 | 0 | 0 | -0.39 | 26.22 | 0 | 0
0 | 0.14 | 0 | 0 | 0 | -0.41 | 26.22 | 0 | 0
0 | 0.14 | 0 | 0 | 0 | -0.41 | 26.22 | 0 | 0
0 | 0.14 | 0 | 0 | 0 | -0.45 | 26.23 | 0 | 0
0 | 0.14 | 0 | 0 | 0 | -0.49 | 26.23 | 0 | 0
0 | 0.14 | 0 | 0 | 0 | -0.5 | 26.23 | 0 | 0
0 | 0.14 | 0 | 0 | 0 | -0.5 | 26.23 | 0 | 0
0 | 0.14 | 0 | 0 | 0 | -0.47 | 26.24 | 0 | 0
0 | 0.14 | 0 | 0 | 0 | -0.5 | 26.24 | 0 | 0
0 | 0.14 | 0 | 0 | 0 | -0.53 | 26.24 | 0 | 0
0 | 0.14 | 0 | 0 | 0 | -0.53 | 26.25 | 0 | 0
0 | 0.14 | 0 | 0 | 0 | -0.55 | 26.25 | 0 | 0
0 | 0.14 | 0 | 0 | 0 | -0.58 | 26.25 | 0 | 0
0 | 0.14 | 0 | 0 | 0 | -0.61 | 26.25 | 0 | 0
0 | 0.14 | 0 | 0 | 0 | -0.62 | 26.26 | 0 | 0
0 | 0.14 | 0 | 0 | 0 | -0.61 | 26.26 | 0 | 0
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
3 | -7.74 | 10.7 | -100.29 | 126.28 | -1.91 | 26.49 | 2.67 | 17
3 | -6.44 | 8.46 | -165.88 | 211.96 | -1.76 | 26.54 | 2.12 | 28
3 | -5 | 6.09 | -215.01 | 270.86 | -1.48 | 26.6 | 1.52 | 39
3 | -3.7 | 3.89 | -249.55 | 303.04 | -1.05 | 26.65 | 0.97 | 49

Sheet: Sheet1
Column1
0,0,0,0,0,0,0,0,0
0,0.05,0,0,0,-0.16,21.8,0,0
0,0.05,0,0,0,-0.19,26.16,0,0
0,0,0,0,0,-0.17,26.17,0,0
0,-0.02,0,0,0,-0.18,26.17,0,0
0,0.1,0,0,0,-0.2,26.18,0,0
0,0.12,0,0,0,-0.23,26.18,0,0
0,0.1,0,0,0,-0.25,26.19,0,0
0,0.12,0,0,0,-0.3,26.2,0,0
0,0.14,0,0,0,-0.35,26.2,0,1
0,0.14,0,0,0,-0.41,26.2,0,0
0,0.14,0,0,0,-0.42,26.21,0,0
0,0.14,0,0,0,-0.4,26.21,0,0
0,0.14,0,0,0,-0.4,26.21,0,0
0,0.14,0,0,0,-0.38,26.22,0,0
0,0.14,0,0,0,-0.39,26.22,0,0
0,0.14,0,0,0,-0.41,26.22,0,0
0,0.14,0,0,0,-0.41,26.22,0,0
0,0.14,0,0,0,-0.45,26.23,0,1
0,0.14,0,0,0,-0.49,26.23,0,0
0,0.14,0,0,0,-0.5,26.23,0,0
0,0.14,0,0,0,-0.5,26.23,0,0
0,0.14,0,0,0,-0.47,26.24,0,0
0,0.14,0,0,0,-0.5,26.24,0,0
0,0.14,0,0,0,-0.53,26.24,0,0
0,0.14,0,0,0,-0.53,26.25,0,0
0,0.14,0,0,0,-0.55,26.25,0,0
0,0.14,0,0,0,-0.58,26.25,0,0
0,0.14,0,0,0,-0.61,26.25,0,1
0,0.14,0,0,0,-0.62,26.26,0,0
0,0.14,0,0,0,-0.61,26.26,0,0
0,0.14,0,0,0,-0.6,26.26,0,0
0,0.14,0,0,0,-0.61,26.26,0,0
0,0.14,0,0,0,-0.58,26.27,0,0
0,0.14,0,0,0,-0.54,26.27,0,0
0,0.1,0,0,0,-0.55,26.27,0,0
0,0.22,0,0,0,-0.56,26.27,0,0
0,0.02,0,0,0,-0.58,26.27,0,1
0,0.14,0,0,0,-0.59,26.27,0,0
0,0.41,0,0,0,-0.58,26.27,0,0
0,0.24,0,0,0,-0.61,26.27,0,0
0,0.07,0,0,0,-0.6,26.28,0,0
0,-0.34,0,0,0,-0.59,26.28,0,0
0,-0.22,0,0,0,-0.6,26.28,0,0
0,-0.41,0,0,0,-0.59,26.28,0,0
0,-0.96,0,0,0,-0.65,26.28,0,0
0,-1.01,0,0,0,-0.67,26.28,0,0
0,-0.65,0,0,0,-0.64,26.28,0,1
0,-0.43,0,0,0,-0.64,26.29,0,0
0,-0.65,0,0,0,-0.63,26.29,0,0
0,-0.82,0,0,0,-0.66,26.29,0,0
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
3,-9.09,12.97,-18.94,21.01,-1.99,26.45,3.24,6
3,-9.09,12.94,-19.49,21.39,-2.03,26.45,3.24,7
3,-7.74,10.7,-100.29,126.28,-1.91,26.49,2.67,17
3,-6.44,8.46,-165.88,211.96,-1.76,26.54,2.12,28
3,-5,6.09,-215.01,270.86,-1.48,26.6,1.52,39
3,-3.7,3.89,-249.55,303.04,-1.05,26.65,0.97,49
